dmbeaudet/gree-zone-controller/(commit log)

2026-05-20 feat: v0.2 — zone controller with PID pressure, virtual temp, anti-short-cycle
    [GreeZoneController.ino, config.h, pressure.h, protocol.h]
2026-05-20 fix: seven correctness bugs in protocol handling and control logic
    Zone 2 UART (critical): SoftwareSerial cannot generate or check 8E1
    parity. 0x7E headers have even parity (bit=0), which 8N1 software UART
    misreads as a start bit -- 100% packet loss on Zone 2. Moved Zone 2 to
    HardwareSerial(UART0) with SERIAL_8E1; requires USB CDC On Boot so Serial
    stays on native USB-CDC. Zone 3 still needs SC16IS752 (see COMMISSIONING.md).
    Room temp fallback: TEMP_ENCODE(16C) == 0x00, triggering AH-sensor
    fallback when room is exactly 16C. Added ROOM_TEMP_BYTE_VERIFIED flag in
    config.h; also added constrain(16,30) on the fallback (ah.indoorTempC is int8_t).
    MQTT reconnect: mqtt.connect() was called every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
    [GreeZoneController.ino, config.h, protocol.h]
2026-05-20 feat: Zone 3 SC16IS752 I2C UART driver replaces SoftwareSerial
    SoftwareSerial (8N1) could not receive the Gree RS485 protocol because
    the 0x7E packet-header byte has even parity (bit=0), which 8N1 software
    UART misreads as a start bit on every frame -- 100% packet loss.
    Adds sc16is752.h: a bundled minimal I2C driver for the SC16IS752 dual-UART
    bridge (no external library required). Configured for the purchased module:
    - Crystal: 14.7456 MHz, divisor 192 -> exact 4800 baud, zero error
    - Format: 8E1 (LCR=0x1B)
    - TX: burst-writes full packet to 64-byte FIFO in one I2C transaction,
    then polls LSR[TEMT] until shift register drains before releasing
    the MAX485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
    [GreeZoneController.ino, config.h, sc16is752.h]
